andyxu925/enel300-g23/report/esppcb.pdf

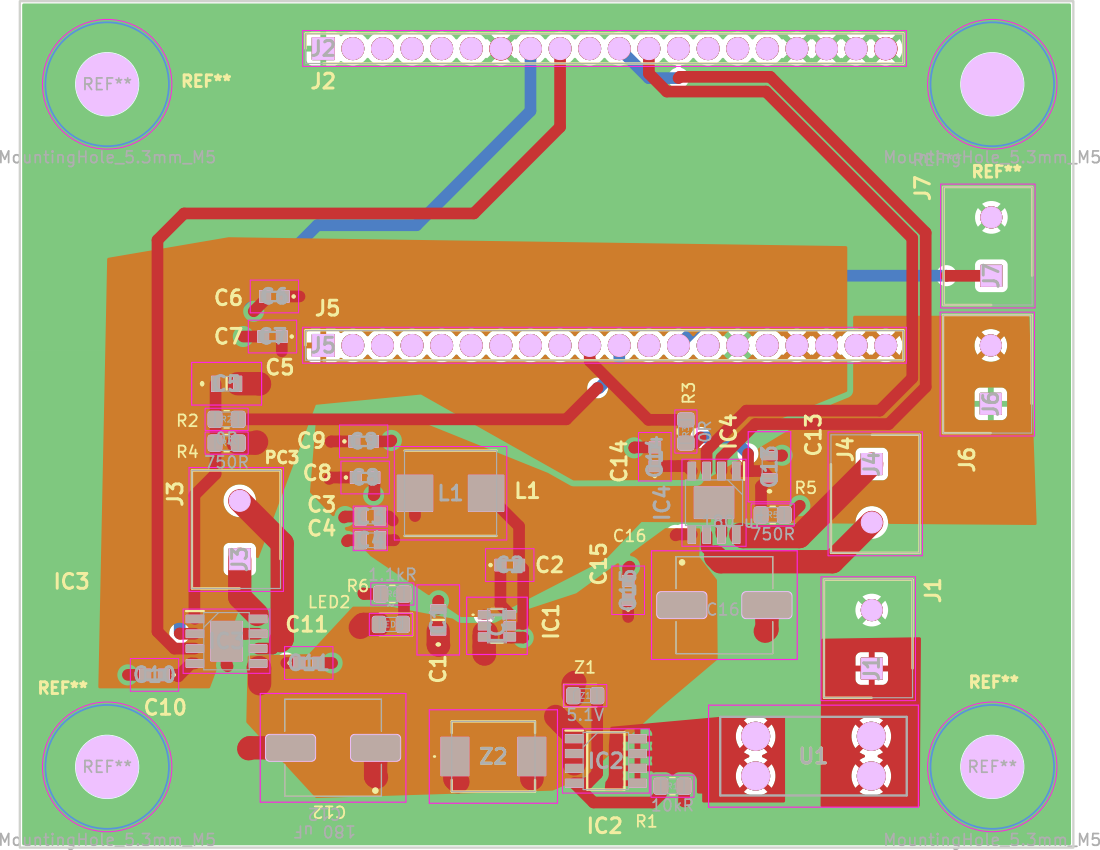
[picture p35: page 1]
