andyxu925/enel300-g23/report/stmpcb.pdf

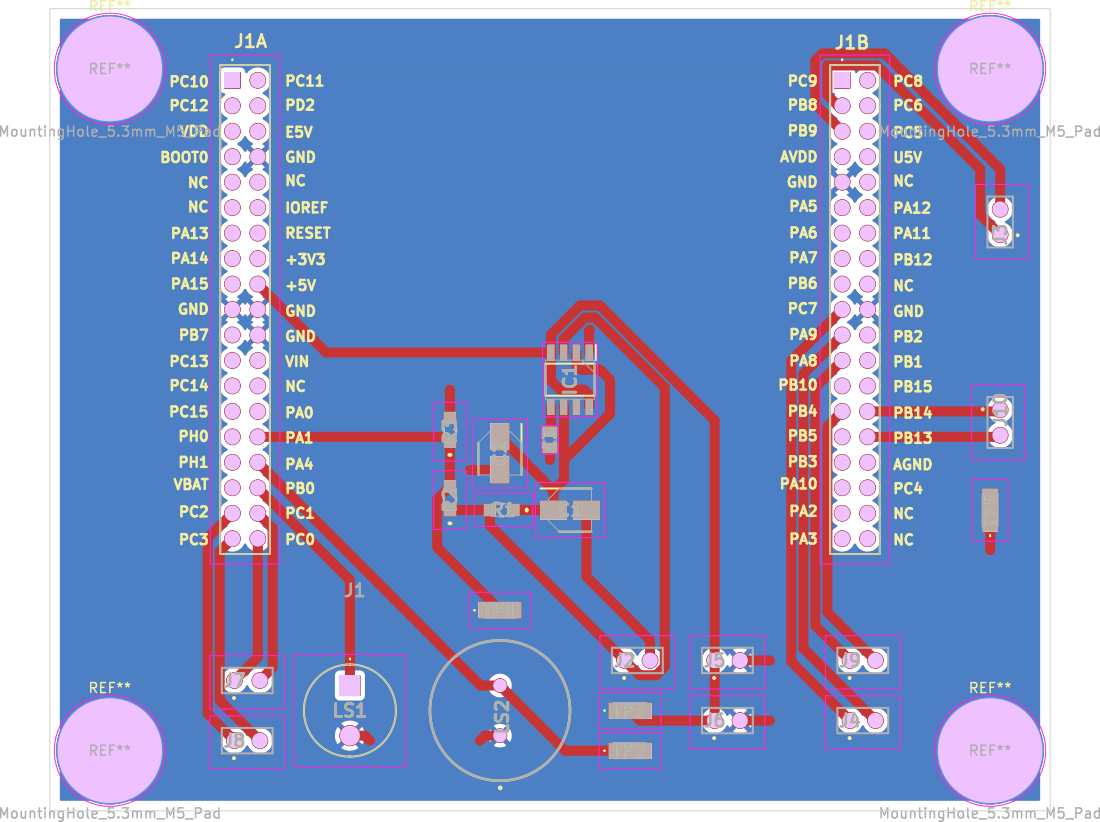
[picture p36: page 1]
