andyxu925/enel300-g23/report/espsch.pdf

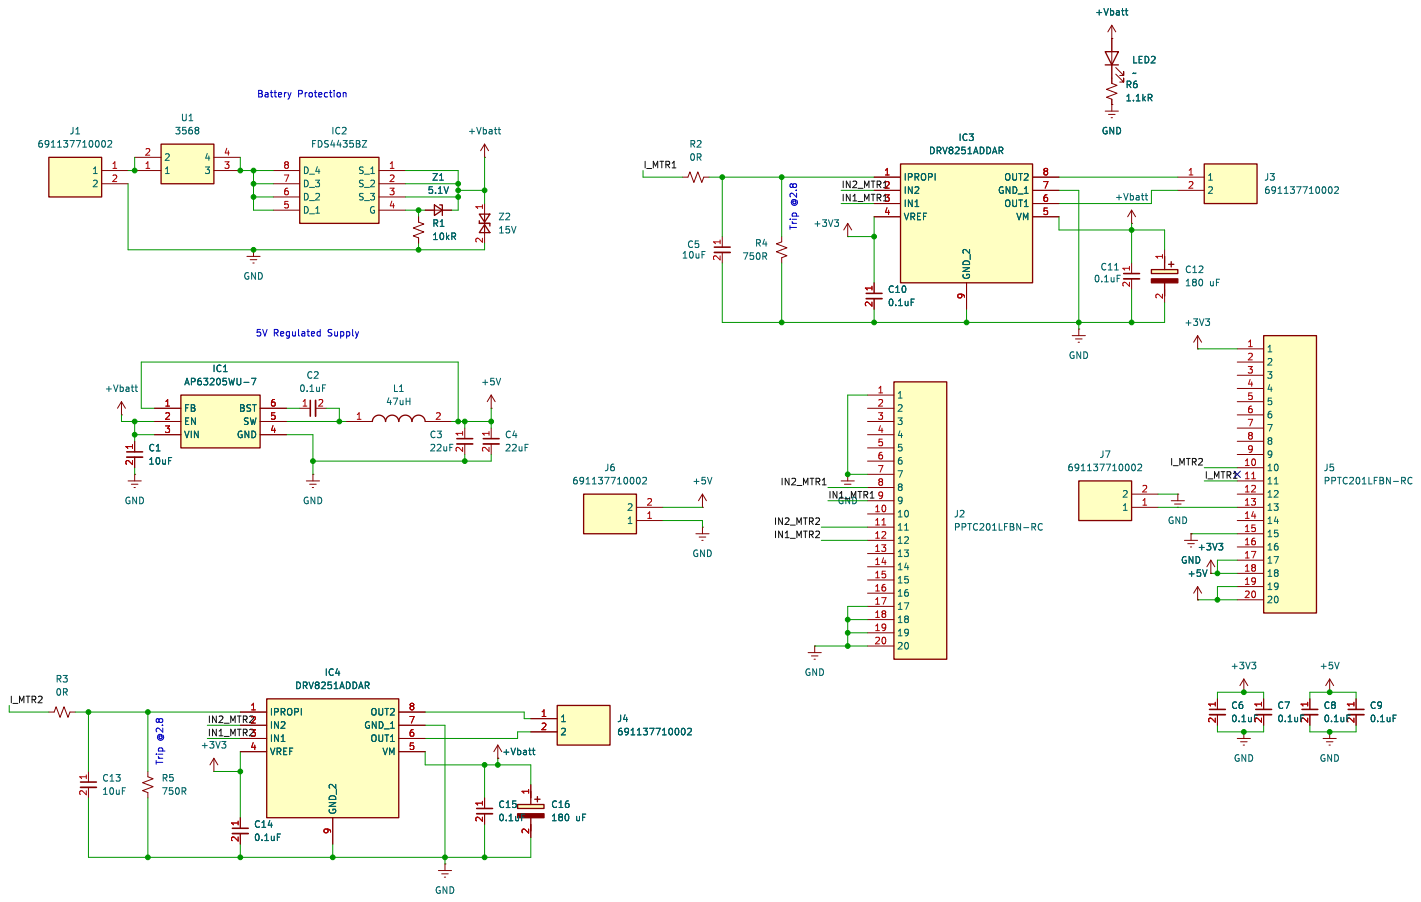
[picture p37: page 1]
