andyxu925/enel300-g23/report/stmsch.pdf

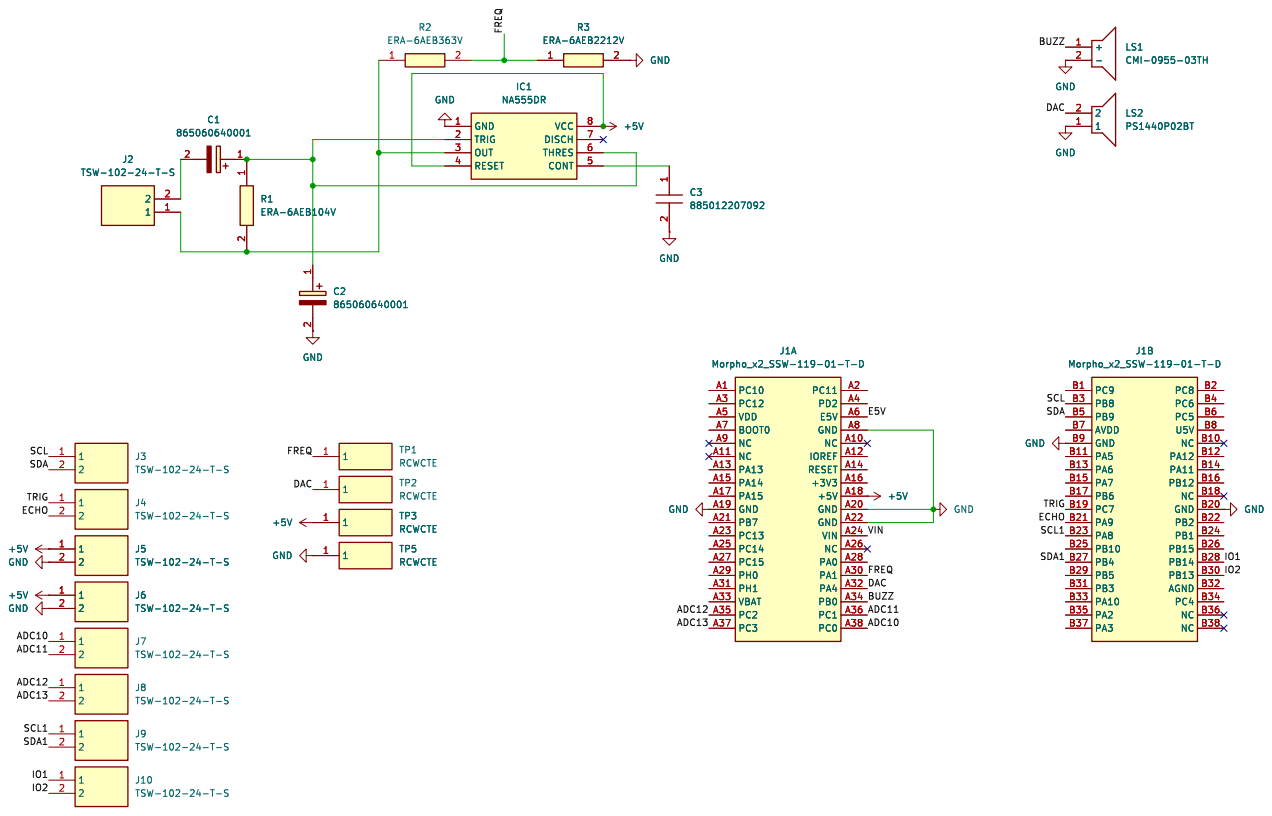
[picture p38: page 1]
