andyxu925/enel300-g23/report/Logo_Vert_Black-eps-converted-to.pdf

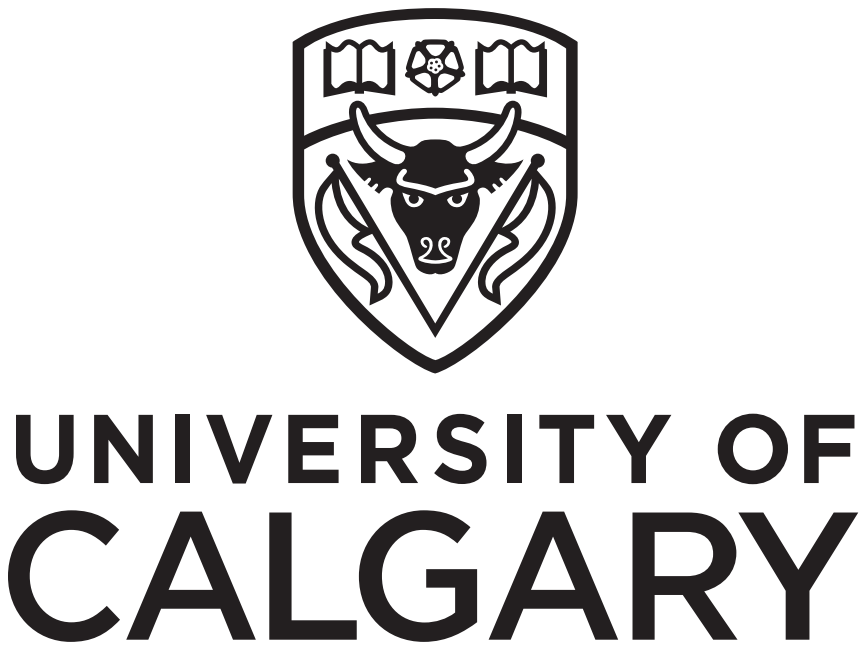
[picture p39: page 1]
