andyxu925/enel300-g23/stm_final/Core/Src/main.c

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
/* Includes ------------------------------------------------------------------*/
#include "main.h"

/* USER CODE BEGIN Includes */
#include "stdio.h"
#include "ultrasonic.h"
#include "lcd.h"
/* USER CODE END Includes */

ADC_HandleTypeDef hadc1;

DAC_HandleTypeDef hdac;
DMA_HandleTypeDef hdma_dac1;

I2C_HandleTypeDef hi2c1;

TIM_HandleTypeDef htim2;

UART_HandleTypeDef huart2;

void SystemClock_Config(void);
static void MX_GPIO_Init(void);
static void MX_DMA_Init(void);
static void MX_ADC1_Init(void);
static void MX_I2C1_Init(void);
static void MX_USART2_UART_Init(void);
static void MX_TIM2_Init(void);
static void MX_DAC_Init(void);
/**
  * @brief  The application entry point.
  * @retval int
  */
int main(void)
{

  /* MCU Configuration--------------------------------------------------------*/

  /* Reset of all peripherals, Initializes the Flash interface and the Systick. */
  HAL_Init();

  /* Configure the system clock */
  SystemClock_Config();

  /* Initialize all configured peripherals */
  MX_GPIO_Init();
  MX_DMA_Init();
  MX_ADC1_Init();
  MX_I2C1_Init();
  MX_USART2_UART_Init();
  MX_TIM2_Init();
  MX_DAC_Init();
  /* USER CODE BEGIN 2 */
  ultrasonic_init();
  float dist_num = 0;
  char dist_str[32] = {0};
  lcd_init(&hi2c1);

  const uint16_t MEAS_INTERVAL = 200;
  uint32_t freq_num = 0;
  uint32_t time_num = 0;
  uint8_t previous_state = 0;
  uint8_t current_state = 0;
  uint8_t check_state = 0;
  char freq_str[32] = {0};

  uint16_t adc_num = 0;
  char adc_str[32] = {0};

  /* USER CODE END 2 */

  /* Infinite loop */
  /* USER CODE BEGIN WHILE */
  while (1)
  {
    for (int i = 0; i < 3; ++i)
    {
      freq_num = 0;
      time_num = HAL_GetTick();
      previous_state = HAL_GPIO_ReadPin(FREQ_IN_GPIO_Port, FREQ_IN_Pin);
      while (HAL_GetTick() - time_num < MEAS_INTERVAL)
      {
        current_state = HAL_GPIO_ReadPin(FREQ_IN_GPIO_Port, FREQ_IN_Pin);
        if (previous_state == GPIO_PIN_RESET && current_state == GPIO_PIN_SET)
        {
          freq_num += 1;
        }
        previous_state = current_state;
      }

      freq_num *= 5;

      dist_num = ultrasonic_echo();

      HAL_ADC_Start(&hadc1);
      HAL_ADC_PollForConversion(&hadc1, 100);
      adc_num = HAL_ADC_GetValue(&hadc1);
      snprintf(adc_str, sizeof(adc_str), "ADC: %d\r\n\n", adc_num);
      HAL_UART_Transmit(&huart2, (uint8_t *)adc_str, sizeof(adc_str), 100);

      snprintf(freq_str, sizeof(freq_str), "Frequency (Hz): %lu\r\n", freq_num);
      HAL_UART_Transmit(&huart2, (uint8_t *)freq_str, sizeof(freq_str), 100);

      snprintf(dist_str, sizeof(dist_str), "Distance (cm): %f\r\n", dist_num);
      HAL_UART_Transmit(&huart2, (uint8_t *)dist_str, sizeof(dist_str), 100);

      snprintf(freq_str, sizeof(freq_str), "%lu %d", freq_num, adc_num);
      snprintf(dist_str, sizeof(dist_str), "Dist(cm):%.4f", dist_num);

      lcd_clear();

      lcd_set_cursor(0, 0);
      lcd_str(freq_str);

      lcd_set_cursor(1, 0);
      lcd_str(dist_str);

      if (freq_num > 7500 + adc_num)
      {
        check_state = 1;
      }
      else
      {
        check_state = 0;
        break;
      }
    }

    if (check_state)
    {
    	HAL_GPIO_WritePin(BUZZ_OUT_GPIO_Port, BUZZ_OUT_Pin, GPIO_PIN_SET);
    }
    else
    {
    	HAL_GPIO_WritePin(BUZZ_OUT_GPIO_Port, BUZZ_OUT_Pin, GPIO_PIN_RESET);
    }

    HAL_Delay(10);
    /* USER CODE END WHILE */

    /* USER CODE BEGIN 3 */
  }
  /* USER CODE END 3 */
}

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
