andyxu925/enel300-g23/stm_final/Core/Inc/main.h

#define B1_Pin GPIO_PIN_13
#define B1_GPIO_Port GPIOC
#define FREQ_IN_Pin GPIO_PIN_1
#define FREQ_IN_GPIO_Port GPIOA
#define USART_TX_Pin GPIO_PIN_2
#define USART_TX_GPIO_Port GPIOA
#define USART_RX_Pin GPIO_PIN_3
#define USART_RX_GPIO_Port GPIOA
#define LD2_Pin GPIO_PIN_5
#define LD2_GPIO_Port GPIOA
#define BUZZ_OUT_Pin GPIO_PIN_0
#define BUZZ_OUT_GPIO_Port GPIOB
#define TRIG_Pin GPIO_PIN_7
#define TRIG_GPIO_Port GPIOC
#define ECHO_Pin GPIO_PIN_9
#define ECHO_GPIO_Port GPIOA
#define TMS_Pin GPIO_PIN_13
#define TMS_GPIO_Port GPIOA
#define TCK_Pin GPIO_PIN_14
#define TCK_GPIO_Port GPIOA
#define SWO_Pin GPIO_PIN_3
#define SWO_GPIO_Port GPIOB
#define SCL_Pin GPIO_PIN_8
#define SCL_GPIO_Port GPIOB
#define SDA_Pin GPIO_PIN_9
#define SDA_GPIO_Port GPIOB
