andyxu925/enel300-g23/esp32/web_server.h

/* #ifndef web_server_h
#define web_server_h

// just defining web_str for other files
void web_str(void);
//void start_webserver(void);
//void start_webserver(void)

#endif

// done
*/

#ifndef WEBSERVER_H
#define WEBSERVER_H

void web_str(void);

#endif
