andyxu925/enel300-g23/(commit log)

2026-03-02 Update and rename sdkconfig to esp32/sdkconfig
2026-03-02 Update and rename sdkconfig.old to esp32/sdkconfig.old
2026-03-03 Update and rename .cproject to stm32/.cproject
2026-03-03 Update and rename .mxproject to stm32/.mxproject
2026-03-03 Update and rename .project to stm32/.project
2026-03-03 Update and rename MetalDetection Debug.launch to stm32/MetalDetection Debug.launch
2026-03-03 Update and rename MetalDetection.ioc to stm32/MetalDetection.ioc
