andyxu925/enel300-g23/(notices)

Notices in the files:
stm_final/Core/Src/main.c:
Copyright (c) 2026 STMicroelectronics.
All rights reserved.
This software is licensed under terms that can be found in the LICENSE file
